todocono/sensoryPod/PCB/sensoryPod_flex_v2_assembly.pdf

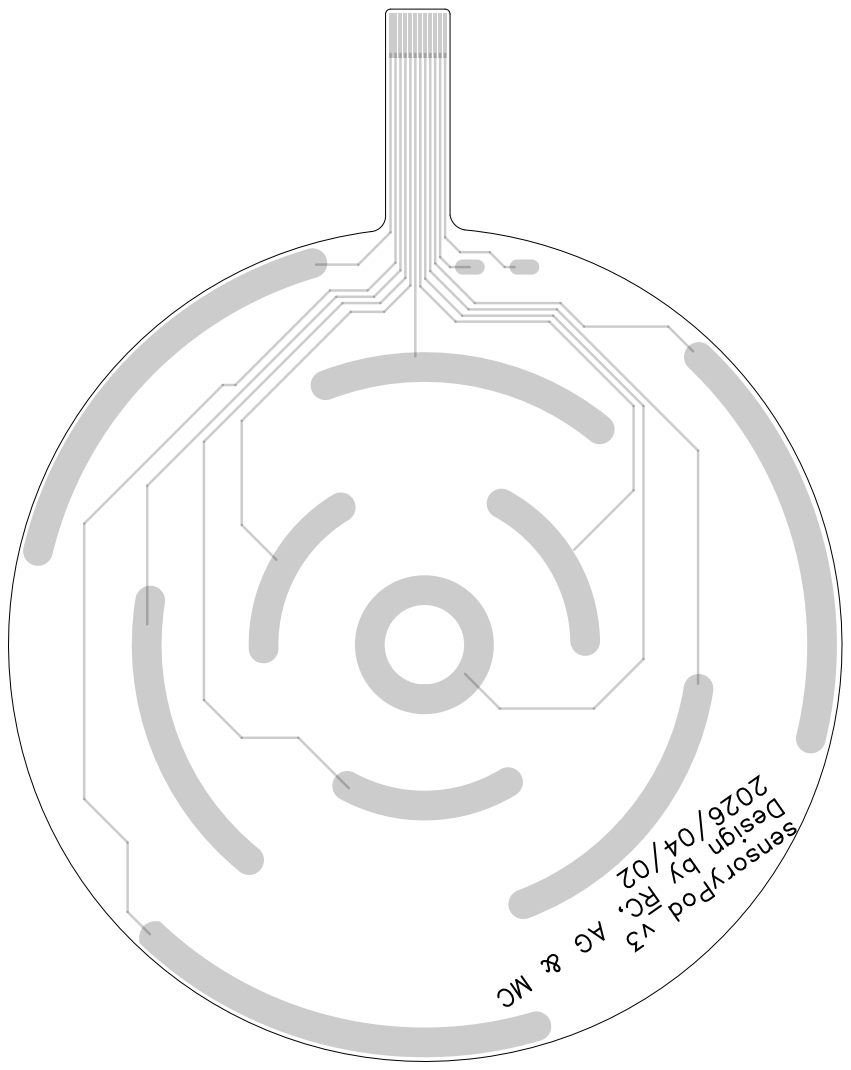
[picture p1: page 1]
sensoryPod_v3

Design by RC, AG & MC
