todocono/sensoryPod/PCB/sensoryPod_rigid_v2_assembly.pdf

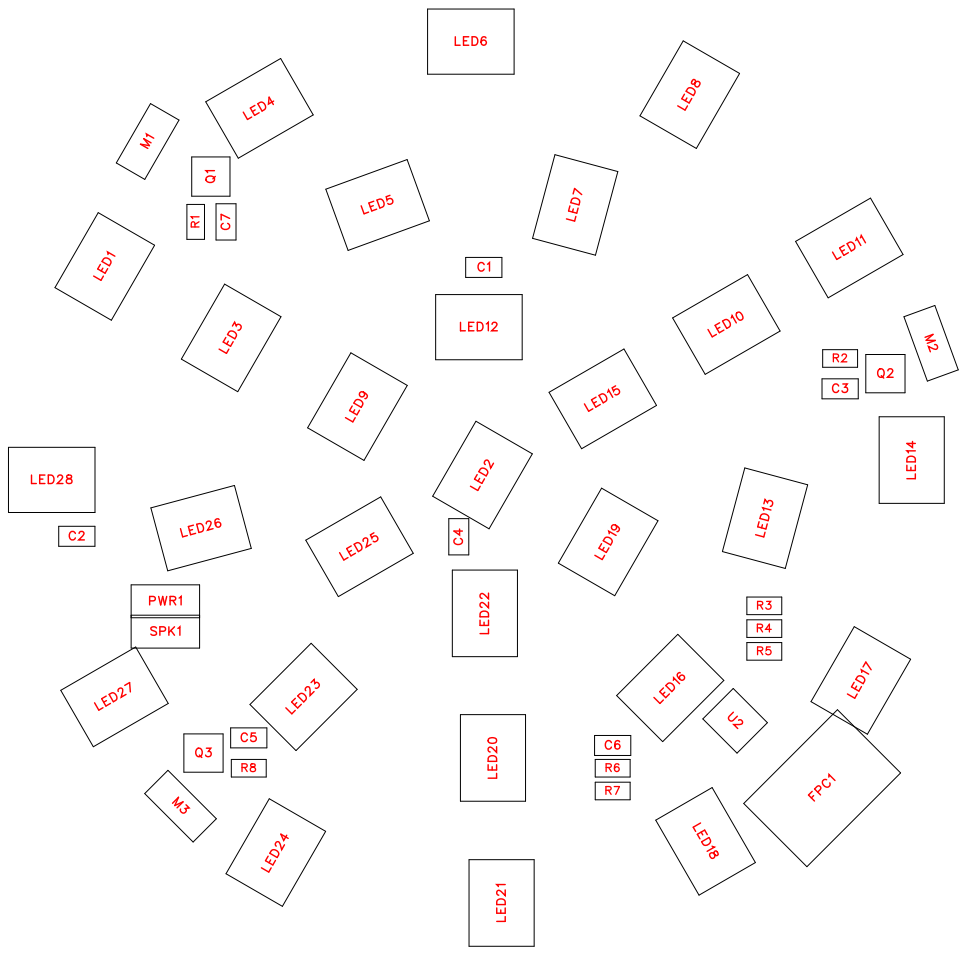
[picture p2: page 1]

U1

P2A

P1

No. | Quantity | Comment | Designator | Footprint | Value | Manufacturer Part | Manufacturer | Supplier Part | Supplier
1 | 7 | 100nF | C1,C2,C3,C4,C5,C6,C7 | C0603 | 100nF | CGA0603X7 R104K500JT | HRE(芯声) | C6119867 | LCSC
2 | 1 | FH12A-12S-0.5SH(55) | FPC1 | CONN-SMD_ FH12A-12S-0.5SH-55 | | FH12A-12S-0.5SH(55) | HRS(广濑) | C596811 | LCSC
3 | 28 | WS2812B-B/ W | LED1,LED2,LED3,LED4,LE D5,LED6,LED7,LED8,LED9 ,LED10,LED11,LED12,LED 13,LED14,LED15,LED16,LE D17,LED18,LED19,LED20, LED21,LED22,LED23,LED2 4,LED25,LED26,LED27,LE D28 | LED-SMD_4 P-L5.0-W5.0-BL_TC5050R GB | | WS2812B-B/ W | worldsemi | C114586 | LCSC
4 | 5 | B-2200S02P-A120 | M1,M2,M3,PWR1,SPK1 | HDR-TH_2P-P2.54-V-F | | B-2200S02P-A120 | Ckmtw(灿科 盟) | C124411 | LCSC
5 | 1 | PZ254V-11-1 0P | P1 | HDR-TH_10 P-P2.54-V-M | | PZ254V-11-1 0P | XFCN(兴飞) | C492409 | LCSC
6 | 1 | 2.54-1*6 | P2A | HDR-TH_6P-P2.54-V-M | | 2.54-1*6 | ZHOURI(洲 日) | C5156615 | LCSC
7 | 3 | S9013-E | Q1,Q2,Q3 | SOT-23-3_L2 .9-W1.3-P1.9 0-LS2.4-BR | | S9013-E | MDD(辰达半 导体) | C41371419 | LCSC
8 | 3 | 1k | R1,R2,R8 | R0603 | 1k | SCR0603J1K | VO(翔胜) | C3017736 | LCSC
9 | 4 | 10k | R3,R4,R5,R6 | R0603 | 10k | FRC0603F10 02TS | FOJAN(富捷) | C2906982 | LCSC
10 | 1 | 75k | R7 | R0603 | 75k | 0603WAF75 02T5E | UNI-ROYAL( 厚声) | C23242 | LCSC
11 | 1 | XIAO ESP32C3 | U1 | COMM-SMD _KQ-2801_V 106 | | XIAO ESP32C3 | | C19189385 | LCSC
12 | 1 | MPR121QR2 | U2 | QFN-20_L3.0 -W3.0-P0.40-BL | | MPR121QR2 | NXP(恩智浦) | C91322 | LCSC

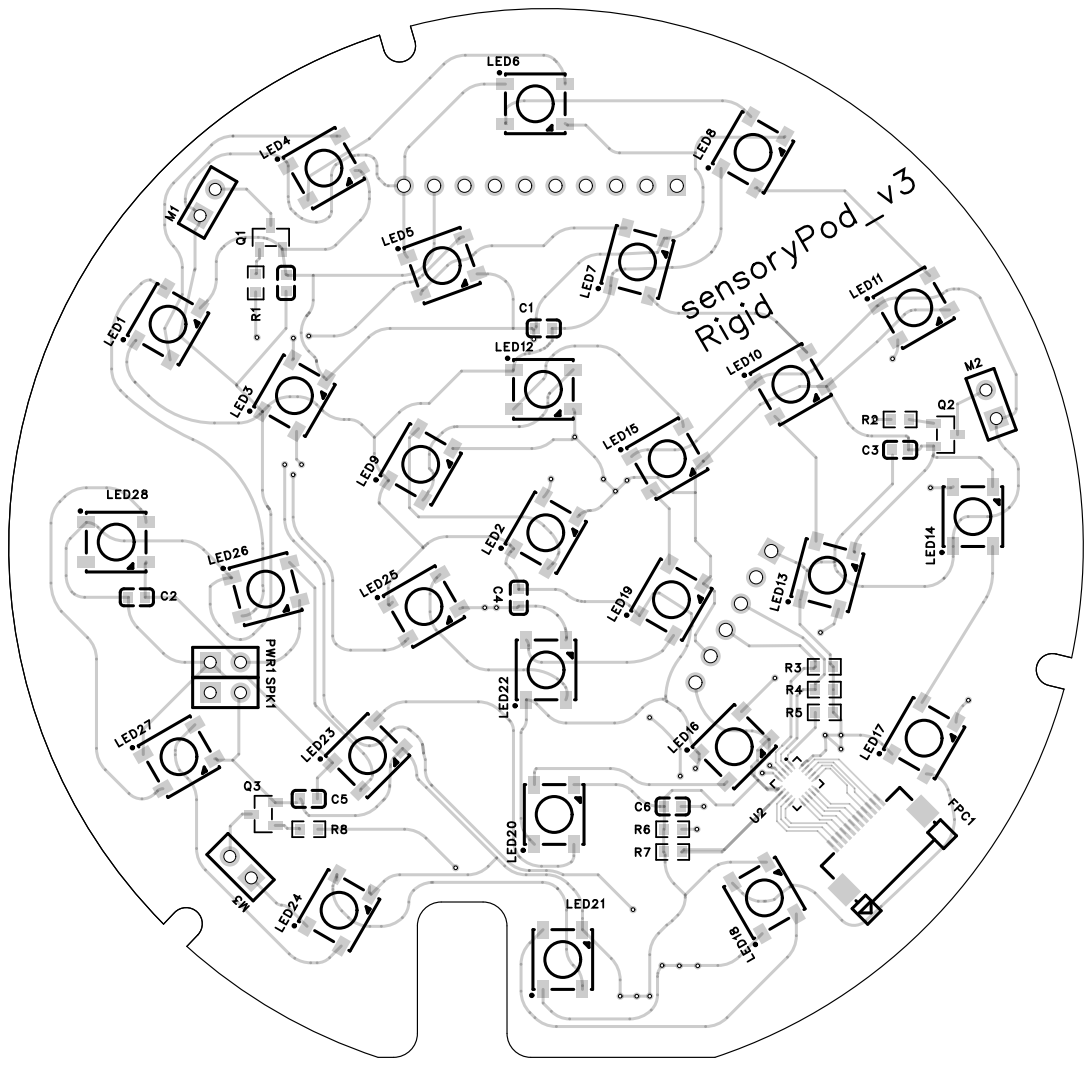
[picture p3: page 4]

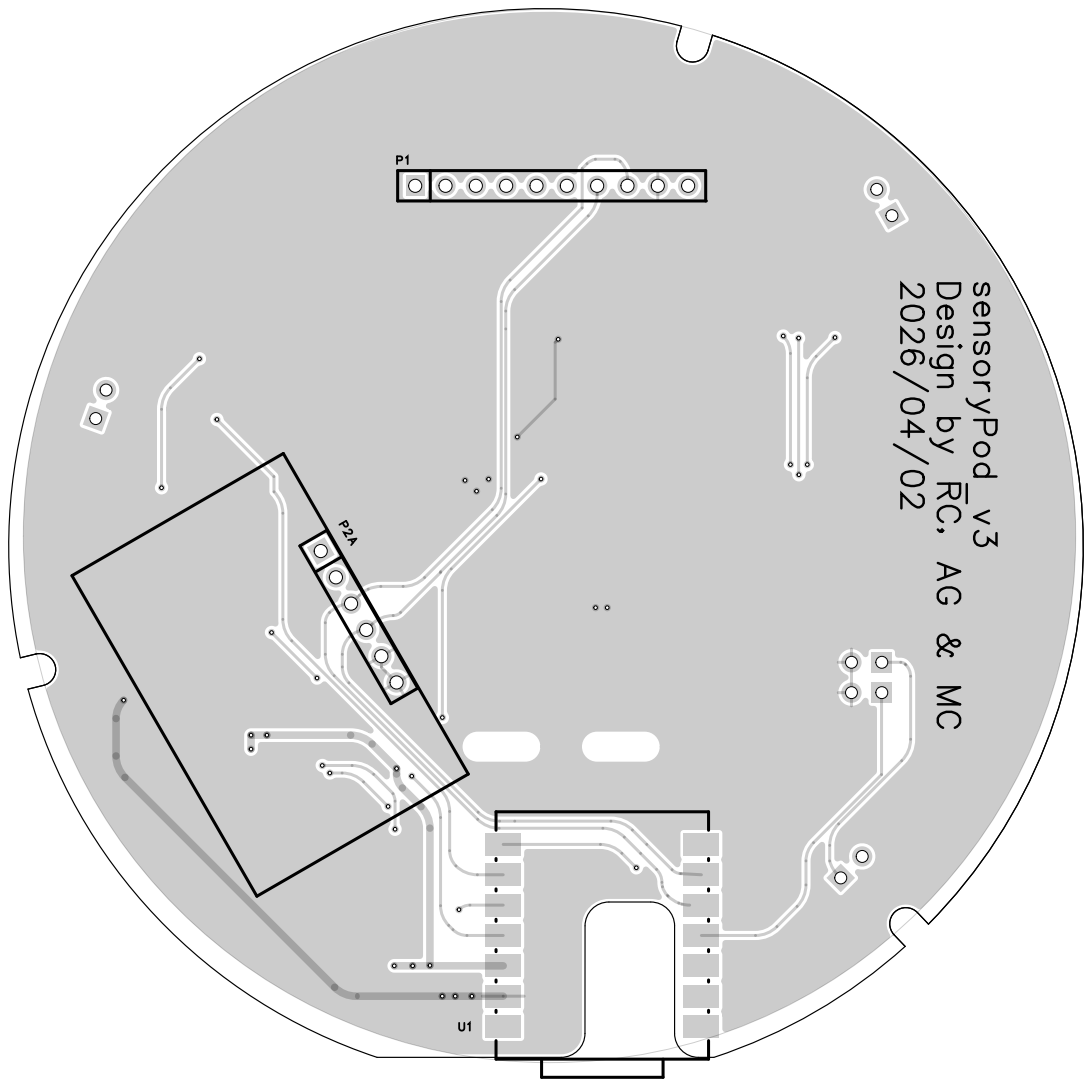
[picture p4: page 5]

Design by RC, AG & MC

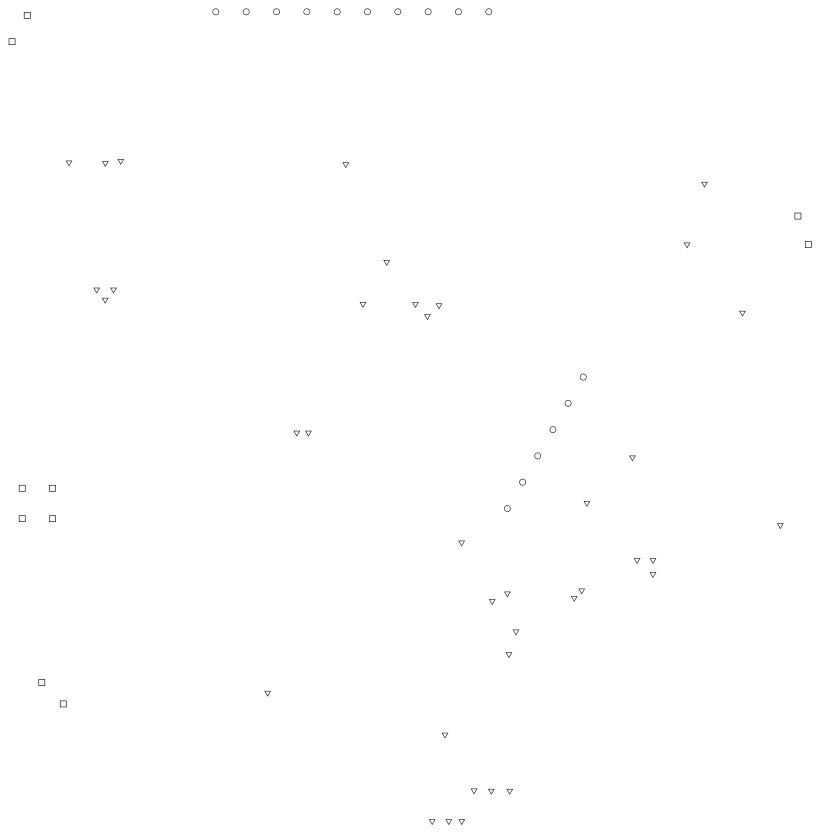
[picture p5: page 6]
