todocono/sensoryPod/PCB/sensoryPod_rigid_v2.pdf

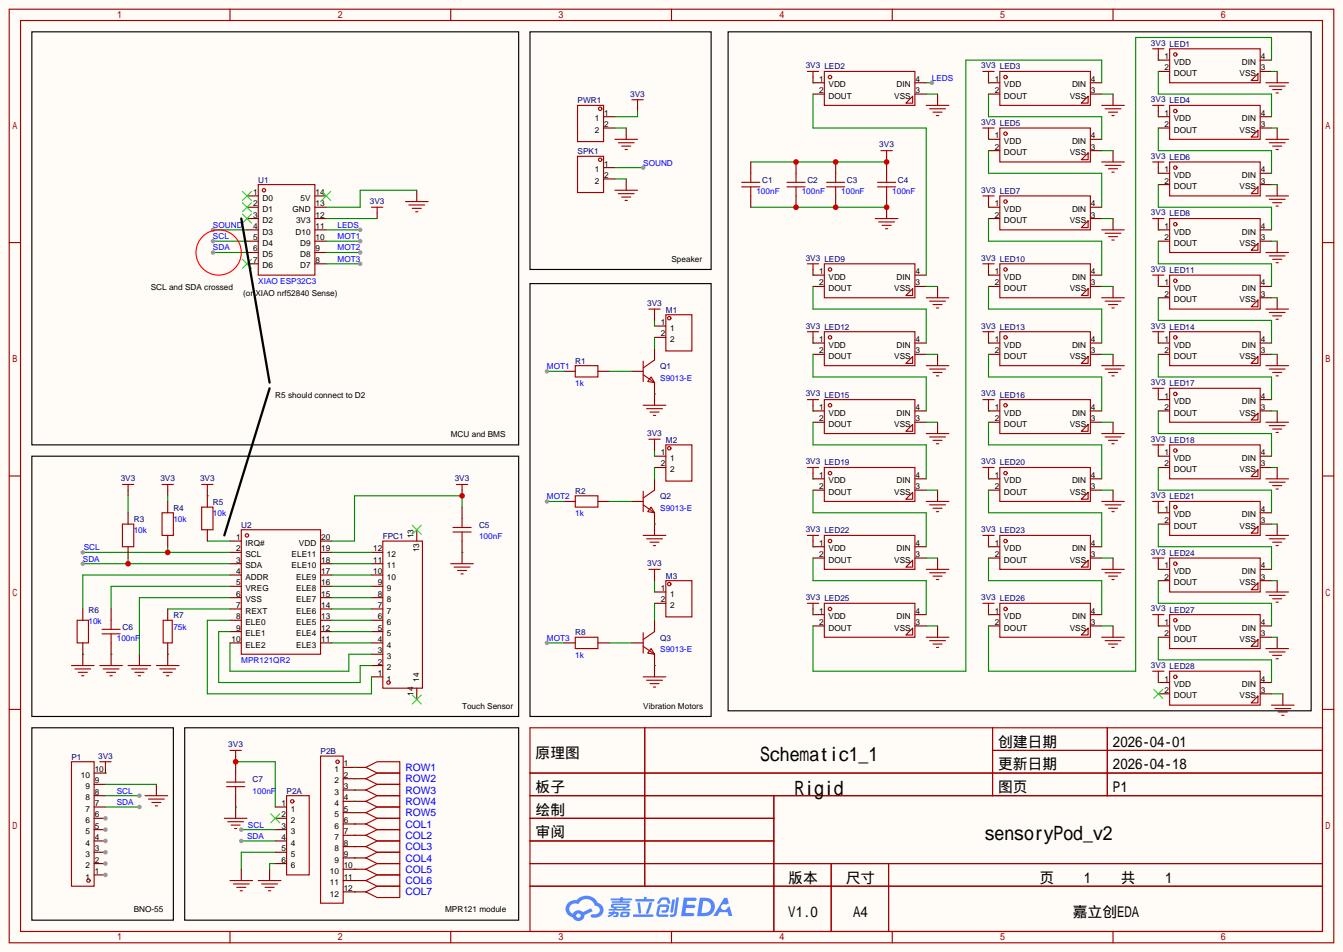
[picture p6: page 1]

SCL and SDA crossed

原理图 | Schematic1_1 | 创建日期 | 2026-04-01

更新日期 | 2026-04-18

板子 | Rigid | 图页 | P1
绘制 | | sensoryPod_v2
审阅

V1.0 | A4 | 嘉立创EDA
