todocono/sensoryPod/MPR121_20260418/MPR121_20260418.ino

#include <SlowSoftI2CMaster.h>
#include "Adafruit_TinyUSB.h"
#define MPR121_I2C_ADDRESS 0x5A  // Default MPR121 Address 0x5A

// Define one of these filter types, or 0 for no specific filter logic in Pol_mouse_dat
#define FILTER_NONE 0
#define FILTER_G 1  // Example: Gaussian-like filter
#define FILTER_D 2  // Example: Derivative-like filter
#define FILTER_A 3  // Example: Another filter type

#define CURRENT_FILTER FILTER_G  // CHOOSE YOUR FILTER TYPE HERE

// Sensitivity thresholds for mouse movement - TUNE THESE!
// These are used in the DX/DY scaling part of Pol_mouse_dat_arduino
#define S_X 20  // Example: Increased from 20 due to larger coordinate range from GetPosXY
#define S_Y 20  // Example: Increased from 20

// Touch and Release Thresholds (as in original code)
// More sensitive (adjust these values as needed):
#define TouchThre 6  // Lower value means easier to trigger touch
#define ReleaThre 4  // Keep release slightly lower than touch


// --- Global Variables ---
// Buffer to store raw register data from MPR121
// Registers 0x00 to 0x2A (inclusive) = 43 bytes
#define MPR121_READ_LENGTH 0x2B  // 43 bytes
uint8_t readingArray[MPR121_READ_LENGTH];

// Delta values for each electrode (signal - baseline)
int16_t ele_delta[13];  // We'll calculate 13, use 12 for X/Y
bool hasKeyPressed = false;

int touchDX, touchDY;

// Touch status structure
struct TouchStatus {
  uint8_t Reg0;
  uint8_t Reg1;
  bool Touched;  // Using bool for Arduino
};


TouchStatus CurrTouchStatus;
TouchStatus PreTouchStatus = { 0, 0, false };  // Initialize previous state

// Variables for X/Y calculation from original code
long SampSumX = 0;
long SampSX = 0;
long SampSumY = 0;
long SampSY = 0;

long CurSumX = 0;
long CurSX = 0;
long CurSumY = 0;
long CurSY = 0;

long PrevSumX = 0;
long PrevSX = 0;
long PrevSumY = 0;
long PrevSY = 0;

int CurPosX = 0;  // Position values (output from GetPosXY, can be large)
int CurPosY = 0;
int PrevPosX = 0;
int PrevPosY = 0;

int SamDX = 0;  // Delta X/Y samples (difference between CurPosX and PrevPosX)
int SamDY = 0;
int CurDX = 0;  // Current delta X/Y (filtered version of SamDX/SamDY)
int CurDY = 0;
int PrevDX = 0;
int PrevDY = 0;


uint8_t FstFlg = 0;   // Flag for ignoring initial samples
bool SndFlg = false;  // Another flag used in filter logic





// use true as third arg, if you do not have external pullups
SlowSoftI2CMaster si = SlowSoftI2CMaster(D5, D4, true);

void setup() {


  Serial.begin(9600);
  while (!Serial)
    ;  // Leonardo: wait for serial monitor
  Serial.println("\nMPR Test");

  if (!si.i2c_init())
    Serial.println(F("Initialization error. SDA or SCL are low"));
  else
    Serial.println(F("...done"));
  MPR121_init_arduino();
  PreTouchStatus.Touched = false;  // Initialize previous states

  Serial.println("\nMPR Test");
}

void loop() {


  /*  byte error, address;
  int nDevices;

  Serial.println(F("Scanning I2C bus (7-bit addresses) ..."));

  nDevices = 0;
  for (address = 1; address < 127; address++) {
    // The i2c_scanner uses the return value of
    // the Write.endTransmisstion to see if
    // a device did acknowledge to the address.
    SoftWire.beginTransmission(address);
    error = SoftWire.endTransmission();

    if (error == 0) {
      Serial.print(F("I2C device found at address 0x"));
      if (address < 16)
        Serial.print(F("0"));
      Serial.print(address, HEX);
      Serial.println(F("  !"));

      nDevices++;
    } else if (error == 4) {
      Serial.print(F("Unknow error at address 0x"));
      if (address < 16)
        Serial.print("0");
      Serial.println(address, HEX);
    }
  }
  if (nDevices == 0)
    Serial.println("No I2C devices found\n");
  else
    Serial.println("done\n");

  delay(5000);  // wait 5 seconds for next scan
  */

  Read_MPR121_ele_register_arduino();  // Reads all relevant registers into readingArray
  Get_ele_data_arduino();              // Calculates ele_delta from readingArray
  Get_touch_status_arduino();          // Updates CurrTouchStatus from readingArray

  if (CurrTouchStatus.Touched) {
    Intp5x7_arduino();  // Calculates SampSumX/Y, SampSX/Y from ele_delta
  } else {
    // If not touched, clear sample sums for next touch to avoid stale data influencing first new touch
    SampSumX = 0;
    SampSX = 0;
    SampSumY = 0;
    SampSY = 0;
  }

  Pol_mouse_dat_arduino();  // Processes data, calculates DX, DY


  // Output calculated data
  //   Serial.print("Touched: "); Serial.print(CurrTouchStatus.Touched);
  //   Serial.print(" | TS: "); Serial.print(CurrTouchStatus.Reg0, HEX); Serial.print(" ");Serial.print(CurrTouchStatus.Reg1, HEX);
  //   Serial.print(" | SampSX: "); Serial.print(SampSX); // Debugging
  //   Serial.print(" SampSY: "); Serial.print(SampSY); // Debugging
  //   Serial.print(" | RawP X: "); Serial.print(CurPosX);
  //   Serial.print(" Y: "); Serial.print(CurPosY);
  //   // Serial.print(" | dX: "); Serial.print(DX);
  //   // Serial.print(" dY: "); Serial.println(DY);
  // Serial.print(DX);
  // Serial.print(',');
  // Serial.println(DY);

  // Optional: Print detailed electrode delta data
  // if (CurrTouchStatus.Touched) {
  // Serial.print();
  for (int k = 3; k < 12; k++) {
    Serial.print(ele_delta[k]);
    Serial.print(",");
  }
  Serial.println("END");
  // }

  // Serial.print(touchDX);
  // Serial.print(',');
  // Serial.println(touchDY);

  delay(20);  // Adjust delay as needed for responsiveness vs. processing load (50Hz)
              // Consider non-blocking timing if other tasks are needed.
}


void MPR121_write_reg(uint8_t reg, uint8_t value) {
  // 1. Send START condition and Address in WRITE mode (Bit shifted + 0)
  if (!si.i2c_start((MPR121_I2C_ADDRESS << 1) | 0)) {
    Serial.print("I2C Write Start Error! Reg: 0x");
    Serial.println(reg, HEX);
    si.i2c_stop();
    return;
  }

  // 2. Send Register and Value immediately
  si.i2c_write(reg);
  si.i2c_write(value);

  // 3. Send STOP condition to release the bus
  si.i2c_stop();
}


bool MPR121_read_block(uint8_t startReg, uint8_t *buffer, uint8_t length) {
  // 1. Point to the register we want to read (Requires WRITE mode first)
  if (!si.i2c_start((MPR121_I2C_ADDRESS << 1) | 0)) {
    Serial.println("I2C Read Setup Error (Start)!");
    si.i2c_stop();
    return false;
  }
  si.i2c_write(startReg);

  // 2. Send REPEATED START condition and switch to READ mode (Bit shifted + 1)
  if (!si.i2c_rep_start((MPR121_I2C_ADDRESS << 1) | 1)) {
    Serial.println("I2C Read Setup Error (Repeated Start)!");
    si.i2c_stop();
    return false;
  }

  // 3. Read the incoming bytes one by one
  for (uint8_t i = 0; i < length; i++) {
    // The i2c_read function needs to know if this is the final byte.
    // We pass 'true' on the last byte to send a NACK (telling the sensor to stop).
    // We pass 'false' on all other bytes to send an ACK (asking for the next byte).
    bool isLastByte = (i == (length - 1));
    buffer[i] = si.i2c_read(isLastByte);
  }

  // 4. Send STOP condition
  si.i2c_stop();
  return true;
}

// --- MPR121 Initialization and Data Processing (Translated) ---
void MPR121_init_arduino() {

  // here there are parameters to adjust, since I used Gemini to translate the i2c routines and it changed some numbers

  Serial.println("Initializing MPR121 Touch sensor");


  MPR121_write_reg(0x80, 0x63);  //Soft reset


  // Stop mode to allow register changes
  MPR121_write_reg(0x5E, 0x00);  // ELECONF: Enter Stop mode
  delay(1);                      // Short delay after stop

  // Soft reset (optional, but good practice if unsure about initial state)
  MPR121_write_reg(0x80, 0x63);  // SOFT_RESET
  delay(10);                     // Allow time for reset

  // Baseline filtering (Original values from your code)
  MPR121_write_reg(0x2B, 0x01);  // MHD_R: Max Half Delta Rising
  MPR121_write_reg(0x2C, 0x01);  // NHD_R: Noise Half Delta Rising
  MPR121_write_reg(0x2D, 0x00);  // NCL_R: Noise Count Limit Rising
  MPR121_write_reg(0x2E, 0x00);  // FDL_R: Filter Delay Limit Rising

  MPR121_write_reg(0x2F, 0x01);  // MHD_F: Max Half Delta Falling
  MPR121_write_reg(0x30, 0x01);  // NHD_F: Noise Half Delta Falling
  MPR121_write_reg(0x31, 0xFF);  // NCL_F: Noise Count Limit Falling
  MPR121_write_reg(0x32, 0x02);  // FDL_F: Filter Delay Limit Falling

  MPR121_write_reg(0x33, 0x00);  // NHD_T: Noise Half Delta Touched (Proximity related)
  MPR121_write_reg(0x34, 0x00);  // NCL_T: Noise Count Limit Touched (Proximity related)
  MPR121_write_reg(0x35, 0x00);  // FDL_T: Filter Delay Limit Touched (Proximity related)

  // Touch/Release Thresholds for all 12 channels
  for (uint8_t i = 0; i < 12; i++) {
    MPR121_write_reg(0x41 + i * 2, TouchThre);  // ELEi_TouchThreshold
    MPR121_write_reg(0x42 + i * 2, ReleaThre);  // ELEi_ReleaseThreshold
  }

  // AFE (Analog Front End) Configuration - INCREASED SENSITIVITY
  // Original from your code: MPR121_write_reg(0x5C, 0xC0); // FFI=3 (1ms), CDC=0 (1uA) - VERY LOW SENSITIVITY
  MPR121_write_reg(0x5C, 0x40);  // New: FFI=0 (0.5ms sample interval), CDC=32uA.
                                 // Try 0x10 for 16uA, or 0x2F for 62uA if needed.
                                 // Values for CDC (bits 5-0): 0x01=1uA, 0x10=16uA, 0x20=32uA, 0x2F=63uA

  MPR121_write_reg(0x5D, 0x00);  // AFE_CONF2: SFI=0 (4 samples), ESI=0 (1ms sample interval) - Default from your code
                                 // ESI (bits 5-0): 0x00=1ms, 0x01=0.5ms. FFI and ESI combine for overall sample rate.

  // Debounce for touch and release (DT and DR bits)
  // Bits 6-4 for DT (touch debounce), Bits 2-0 for DR (release debounce)
  // Value 1 = 1 sample, Value 2 = 2 samples etc.
  MPR121_write_reg(0x5B, (1 << 4) | (1 << 0));  // Debounce: Touch=1 sample, Release=1 sample. (Sensitive)
                                                // Try (2 << 4) | (2 << 0) for 2 samples if too noisy.

  // Auto-Configuration Registers (Original values from your code)
  // These fine-tune the auto-calibration behavior.
  MPR121_write_reg(0x7B, 0xCB);  // AUTO_CONFIG_0 (USL, Target Level related for ELE0-ELE3)
  MPR121_write_reg(0x7C, 0x00);  // AUTO_CONFIG_0 (LSL, Target Level related for ELE0-ELE3) - This was not in your list, typically set. Default may be 0.
                                 // Default for 0x7C by Adafruit library is often 0x8C or LSL = USL * 0.65
  MPR121_write_reg(0x7D, 0xE4);  // AUTO_CONFIG_1 (USL, Target Level related for ELE4-ELE11)
  MPR121_write_reg(0x7E, 0x94);  // AUTO_CONFIG_CONTROL_0 (SFI, RETRY, BVA, ARE, ACE)
  MPR121_write_reg(0x7F, 0xCD);  // AUTO_CONFIG_CONTROL_1 (SCTS, ACFAILI, CL)


  // Enable electrodes and enter Run mode (12 Electrodes)
  MPR121_write_reg(0x5E, 0x0C);  // ELECONF: Enable 12 electrodes (ELE0-ELE11), Target: Run mode

  // Thresholds for the 13th Proximity Electrode (Registers 0x59 and 0x5A)
  // MPR121_write_reg(0x59, 10);  // ELE12 (Proximity) Touch Threshold
  // MPR121_write_reg(0x5A, 8);   // ELE12 (Proximity) Release Threshold


  Serial.println("MPR121 Initialized.");
}

void Read_MPR121_ele_register_arduino() {
  // Read registers 0x00 to 0x2A (43 bytes)
  if (!MPR121_read_block(0x00, readingArray, MPR121_READ_LENGTH)) {
    Serial.println("Failed to read MPR121 registers!");
  }
}

void Get_ele_data_arduino() {
  uint16_t tmp_sig, tmp_bas;
  for (uint8_t i = 0; i < 13; i++) {  // Process 13 values (ELE0-ELE11 and PROX/ELE12)
    // Filtered data: LSB at 0x04 + 2*i, MSB at 0x05 + 2*i
    // The original `readingArray[0x04 + 1 + 2*i]` is MSB, `readingArray[0x04 + 2*i]` is LSB
    tmp_sig = (readingArray[0x04 + (2 * i)] | ((uint16_t)readingArray[0x05 + (2 * i)] << 8));
    // MPR121 Filtered data is 10-bit. The mask 0xFFFC in original code seems to ignore 2 LSBs.
    // Sticking to original mask:
    tmp_sig &= 0xFFFC;

    // Baseline data: 1 byte per channel (0x1E + i), value is upper 8 bits of 10-bit baseline.
    tmp_bas = ((uint16_t)readingArray[0x1E + i]) << 2;

    ele_delta[i] = abs((int16_t)(tmp_sig - tmp_bas));
  }
}

void Get_touch_status_arduino() {
  CurrTouchStatus.Reg0 = readingArray[0x00];  // Touch Status LSB (ELE0-ELE7)
  CurrTouchStatus.Reg1 = readingArray[0x01];  // Touch Status MSB (ELE8-ELE11, plus OOR and PROX)

  // Check if any of the first 12 electrodes are touched
  if (((CurrTouchStatus.Reg0 & 0xFF) != 0) || ((CurrTouchStatus.Reg1 & 0x0F) != 0)) {  // Mask MSB for ELE8-11
    CurrTouchStatus.Touched = true;
  } else {
    CurrTouchStatus.Touched = false;
  }
}

// UPDATED for new electrode mapping
void Intp5x7_arduino() {
  SampSumX = 0;
  SampSX = 0;
  SampSumY = 0;
  SampSY = 0;

  for (uint8_t i = 0; i < 12; i++) {
    // Optional: Add a small threshold for ele_delta to be considered significant for interpolation
    // if (ele_delta[i] < 5) continue; // Example: ignore very small deltas for position calculation

    if (i >= 0 && i <= 4) {          // Electrodes 0-4 for Y-axis (Top Row: ELE0 is Y-pos 1, ELE4 is Y-pos 5)
      long weightY = (long)(i + 1);  // ELE0 -> 1, ELE1 -> 2, ..., ELE4 -> 5
      SampSumY += weightY * ele_delta[i];
      SampSY += ele_delta[i];
    } else if (i >= 5 && i <= 11) {         // Electrodes 5-11 for X-axis (Columns: ELE11=left, ELE5=right)
                                            // ELE11 is X-pos 1, ELE5 is X-pos 7
      long weightX = (long)(1 + (11 - i));  // ELE11 (i=11) -> weight 1; ELE5 (i=5) -> weight 7
      SampSumX += weightX * ele_delta[i];
      SampSX += ele_delta[i];
    }
  }
}

// Filter function from original code
int FilterXY(int prev, int spl, int m) {
  if (m == 1) return prev - (prev >> 2) + (spl >> 2);                                  // 0.75*prev + 0.25*spl
  else if (m == 2) return (prev >> 1) + (spl >> 1);                                    // 0.5*prev + 0.5*spl
  else if (m == 3) return prev - (prev >> 1) + (prev >> 3) + (spl >> 2) + (spl >> 3);  // 0.625*prev + 0.375*spl
  else if (m == 4) return prev - (prev >> 3) + (spl >> 3);                             // 0.875*prev + 0.125*spl
  return spl;                                                                          // Default if m is invalid
}

// Position calculation (fixed-point division) from original code
int GetPosXY(long fz, long fm) {
  int i;
  int w = 0;
  int q = 0, b = 0;
  int s = 0, g = 0;

  if (fm == 0) return 0;
  if (fz == 0) return 0;

  for (i = 0; i < 5; i++) {
    if (fz < fm) {
      if (i == 0) w = 0;
      if (i == 1) q = 0;
      if (i == 2) b = 0;
      if (i == 3) s = 0;
      if (i == 4) g = 0;
      fz = (fz << 3) + (fz << 1);
      continue;
    }
    while (1) {
      fz -= fm;
      if (i == 0) ++w;
      if (i == 1) ++q;
      if (i == 2) ++b;
      if (i == 3) ++s;
      if (i == 4) ++g;
      if (fz < fm) {
        fz = (fz << 3) + (fz << 1);
        break;
      }
    }
  }
  w = (w << 13) + (w << 10) + (w << 9) + (w << 8) + (w << 4);
  q = (q << 9) + (q << 8) + (q << 7) + (q << 6) + (q << 5) + (q << 3);
  b = (b << 6) + (b << 5) + (b << 2);
  s = (s << 3) + (s << 1);
  return w + q + b + s + g;
}

// Main mouse data polling and calculation logic
void Pol_mouse_dat_arduino() {
  if (CurrTouchStatus.Touched) {
    CurSumX = FilterXY(PrevSumX, SampSumX, 1);
    CurSX = FilterXY(PrevSX, SampSX, 1);
    CurSumY = FilterXY(PrevSumY, SampSumY, 1);
    CurSY = FilterXY(PrevSY, SampSY, 1);

    CurPosX = GetPosXY(CurSumX, CurSX);
    CurPosY = GetPosXY(CurSumY, CurSY);

#if CURRENT_FILTER == FILTER_G
    CurPosX = FilterXY(PrevPosX, CurPosX, 2);
    CurPosY = FilterXY(PrevPosY, CurPosY, 2);
    CurDX = CurPosX - PrevPosX;
    CurDY = CurPosY - PrevPosY;
#elif CURRENT_FILTER == FILTER_D
    SamDX = CurPosX - PrevPosX;
    SamDY = CurPosY - PrevPosY;
    CurDX = FilterXY(PrevDX, SamDX, 1);
    CurDY = FilterXY(PrevDY, SamDY, 1);
#elif CURRENT_FILTER == FILTER_A
    CurPosX = FilterXY(PrevPosX, CurPosX, 3);
    CurPosY = FilterXY(PrevPosY, CurPosY, 3);
    SamDX = CurPosX - PrevPosX;
    SamDY = CurPosY - PrevPosY;
    CurDX = FilterXY(PrevDX, SamDX, 3);
    CurDY = FilterXY(PrevDY, SamDY, 3);
#else  // No specific filter or FILTER_NONE
    CurDX = CurPosX - PrevPosX;
    CurDY = CurPosY - PrevPosY;
#endif

    if (!PreTouchStatus.Touched) {
#if CURRENT_FILTER == FILTER_D || CURRENT_FILTER == FILTER_A
      SndFlg = true;
#endif
      PrevSumX = SampSumX;
      PrevSX = SampSX;
      PrevSumY = SampSumY;
      PrevSY = SampSY;
      PrevPosX = GetPosXY(PrevSumX, PrevSX);  // Initialize PrevPosX/Y with first unfiltered position
      PrevPosY = GetPosXY(PrevSumY, PrevSY);
      FstFlg = 0;
    } else {
      if (FstFlg < 3) {
        FstFlg++;
        touchDX = 0;
        touchDY = 0;
      }

      else {

        // I started with:
        // if (((CurDX < S_X) && (CurDX >= 0)) || ((CurDX > -S_X) && (CurDX <= 0))) { DX = 0; } else { ... }
        // For now, using a simplified scaling based on S_X and S_Y.
        // CurDX and CurDY can be large depending on GetPosXY output.
        // S_X and S_Y need to be tuned according to the range of CurDX/CurDY you observe.
        if ((CurPosX != PrevPosX) || (CurPosY != PrevPosY)) {  // Only calculate DX/touchDY if position changed
          if (((CurDX < S_X) && (CurDX >= 0)) || ((CurDX > -S_X) && (CurDX <= 0))) {
            touchDX = 0;
          } else {
            touchDX = CurDX / S_X;                                         // Simple linear scaling. Add 1 for positive, -1 for negative if you want minimum step.
                                                                           // e.g. DX = CurDX > 0 ? (CurDX/S_X + 1) : (CurDX/S_X -1);
            if (touchDX == 0 && CurDX != 0) touchDX = CurDX > 0 ? 1 : -1;  // Ensure at least 1 if non-zero after division
          }

          if (((CurDY < S_Y) && (CurDY >= 0)) || ((CurDY > -S_Y) && (CurDY <= 0))) {
            touchDY = 0;
          } else {
            touchDY = CurDY / S_Y;
            if (touchDY == 0 && CurDY != 0) touchDY = CurDY > 0 ? 1 : -1;
          }
        } else {
          touchDX = 0;
          touchDY = 0;
        }
        // --- END OF DX/DY SCALING SECTION ---
      }
    }
    PrevSumX = CurSumX;
    PrevSX = CurSX;
    PrevSumY = CurSumY;
    PrevSY = CurSY;
    PrevPosX = CurPosX;
    PrevPosY = CurPosY;

#if CURRENT_FILTER == FILTER_D || CURRENT_FILTER == FILTER_A
    if (SndFlg) {
      SndFlg = false;
      PrevDX = SamDX;
      PrevDY = SamDY;
    } else {
      PrevDX = CurDX;
      PrevDY = CurDY;
    }
#else
    PrevDX = CurDX;
    PrevDY = CurDY;
#endif
    PreTouchStatus.Touched = true;
  } else {  // Not touched (finger released)
    FstFlg = 0;
    PreTouchStatus.Touched = false;
    touchDX = 0;
    touchDY = 0;
    // Optionally reset "previous" state variables here if desired for new touch.
    // e.g., PrevPosX = 0; PrevPosY = 0;
    // The current code keeps PrevPosX/Y for filtering continuity if a touch quickly reappears.
  }
}
